Jose-WaitNRest/PCB-Madre/PCB/PCB-Madre.kicad_pcb

## KiCad design PCB/PCB-Madre.kicad_pcb (2026-04-07)

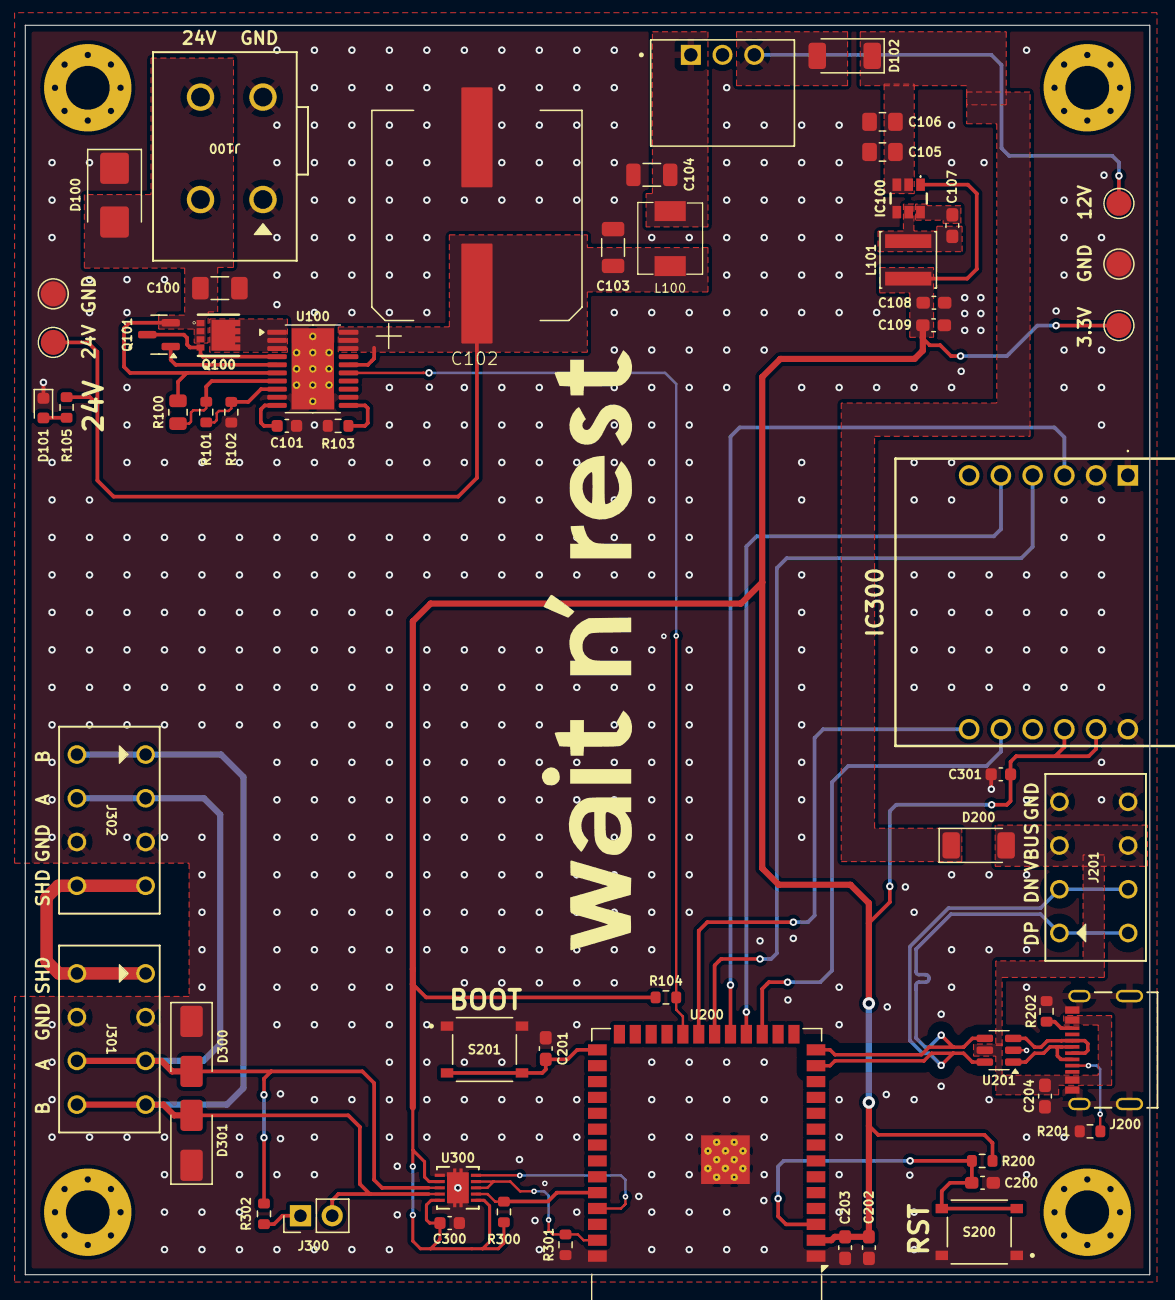
[picture p1: board PCB-Madre.kicad_pcb from above]

Board: 4 copper layers, 90.0 x 100.0 mm, 63 parts (0 on the bottom side), 39 nets.

Parts:
C100: 1uF; C_1206_3216Metric_Pad1.33x1.80mm_HandSolder
C101, C300, C301: 0.1uF; C_0603_1608Metric
C102: 1mF/50V; VKMI1701H102MV
C103, C104: 22uF; C_1206_3216Metric
C105, C106: 10uF; C_0805_2012Metric_Pad1.18x1.45mm_HandSolder
C107, C200, C201, C203, C204: 0.1uF; C_0603_1608Metric_Pad1.08x0.95mm_HandSolder
C108, C109, C202: 22uF; C_0603_1608Metric_Pad1.08x0.95mm_HandSolder
D100: SMBJ28CA-13-F; D_SMB
D101: 19-21/GHC-YR1S2/4T; LED_0603_1608Metric
D102, D200: PMEG3030EP,115; D_SOD-128
D300, D301: SMAJ30CA; D_SMA
H1, H2, H3, H4: MountingHole_Pad; MountingHole_3.5mm_Pad_Via
IC100: AP63203WU-7; AP63203WU7
IC300: WIZ850IO
J100: 2604-3102
J200: 2171790001; MOLEX_2171790001
J201, J301, J302: 2086-1104; 2086-1104-THT
J300: jumper; PinHeader_1x02_P2.54mm_Vertical
L100: 4.7uH; MDA5030-4R7M
L101: 3.9uH; L_Sunlord_SWPA4030S
PS100: R-78K12-2.0; R-78K12-2_0
Q100: CSD19537Q3
Q101: BSS138; SOT-23
R100: 825K; R_0805_2012Metric
R101: 31.6K; R_0603_1608Metric
R102: 34K; R_0603_1608Metric
R103: 9.1K; R_0603_1608Metric
R104, R200, R300, R301: 10K; R_0603_1608Metric
R105: 2.2K; R_0603_1608Metric
R201, R202: 5.1K; R_0603_1608Metric
R302: 120; R_0603_1608Metric
S200, S201: TS-1187A-B-A-B
TP100, TP101, TP102, TP103, TP104: TestPoint; TestPoint_Pad_D2.0mm
U100: TPS26631PWP; HTSSOP-20-1EP_4.4x6.5mm_P0.65mm_EP3.4x6.5mm_Mask2.96x2.96mm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
U200: ESP32-S3-WROOM-1
U201: USBLC6-2SC6; SOT-23-6
U300: THVD2450VDRCR; VSON10_DRC_TEX

Connections:
+3.3V: C108.1, C109.1, C202.1, C203.1, C300.1, C301.1, IC100.1 (FB), IC300.J22 (3.3V_1), IC300.J23 (3.3V_2), L101.2, R104.1, R200.1, R300.1, TP103.1, U200.2 (3V3), U300.1 (VIO), U300.7 (SLR), U300.10 (VCC)
+12V: D102.2 (A), PS100.3 (+VOUT), TP102.1
+24V: C102.1, C103.1, L100.1, R105.1, TP100.1, U100.16 (PGTH), U100.18 (OUT), U100.19 (OUT), U100.20 (OUT)
/12V_5V: C105.1, C106.1, D102.1 (K), D200.1 (K), IC100.2 (EN), IC100.3 (VIN)
/MCU/BOOT: C201.1, S201.C, S201.D, U200.27 (IO0)
/MCU/CLK: IC300.J14 (SCLK), U200.20 (IO12)
/MCU/CS: IC300.J15 (SCNN), U200.18 (IO10)
/MCU/EN: C200.1, R200.2, S200.C, S200.D, U200.3 (EN)
/MCU/FLT: R104.2, U100.15 (~FLT), U200.22 (IO14)
/MCU/MISO: IC300.J26 (MISO), U200.21 (IO13)
/MCU/MOSI: IC300.J13 (MOSI), U200.19 (IO11)
/MCU/N: J200.A7 (DN1), J200.B7 (DN2), U201.1 (I/O1)
/MCU/P: J200.A6 (DP1), J200.B6 (DP2), U201.3 (I/O2)
/MCU/RS485_EN: R301.1, U200.39 (IO1), U300.3 (DE), U300.4 (*RE)
/MCU/RST: IC300.J25 (RSTN), U200.17 (IO9)
/MCU/RX: R300.2, U200.36 (RXD0), U300.2 (R)
/MCU/TX: U200.37 (TXD0), U300.5 (D)
/MCU/USB_N: J201.P2_1, J201.P2_2, U200.13 (IO19), U201.6 (I/O1)
/MCU/USB_P: J201.P1_1, J201.P1_2, U200.14 (IO20), U201.4 (I/O2)
/PERIPHERALS/A: D300.2 (A2), J301.P3_1, J301.P3_2, J302.P2_1, J302.P2_2, R302.2, U300.8 (A)
/PERIPHERALS/B: D301.2 (A2), J300.2, J301.P4_1, J301.P4_2, J302.P1_1, J302.P1_2, U300.9 (B)
/PERIPHERALS/SHIELD: J301.P1_1, J301.P1_2, J302.P4_1, J302.P4_2
/POWER/INPUT: C100.1, D100.2 (A2), J100.3 (2_1), J100.4 (2_2), Q100.1 (S), Q101.2 (S), R100.1, U100.6 (IN_SYS)
GND: C100.2, C101.1, C102.2, C103.2, C104.2, C105.2, C106.2, C108.2, C109.2, C200.2, C201.2, C202.2, C203.2, C204.2, C300.2, C301.2, D100.1 (A1), D101.1 (K), D300.1 (A1), D301.1 (A1), IC100.4 (GND), IC300.J11 (GND_1), IC300.J12 (GND_2), IC300.J21 (GND_3), J100.1 (1_1), J100.2 (1_2), J200.A1B12 (GND1), J200.B1A12 (GND2), J200.SH1 (SHIELD1), J200.SH2 (SHIELD2), J200.SH3 (SHIELD3), J200.SH4 (SHIELD4), J201.P4_1, J201.P4_2, J301.P2_1, J301.P2_2, J302.P3_1, J302.P3_2, PS100.2 (GND), R102.2, R103.2, R201.2, R202.2, R301.2, S200.A, S200.B, S201.A, S201.B, TP101.1, TP104.1, U100.9 (GND), U100.12 (MODE), U100.21 (GND), U200.1 (GND), U200.40 (GND), U200.41 (GND), U201.2 (GND), U300.6 (GND), U300.11 (GND)
unnamed: D101.2 (A), R105.2
unnamed: C107.2, IC100.6 (BST)
unnamed: C107.1, IC100.5 (SW), L101.1
unnamed: J200.A5 (CC1), R201.1
unnamed: J200.B5 (CC2), R202.1
unnamed: J300.1, R302.1
unnamed: C104.1, L100.2, PS100.1 (+VIN)
unnamed: Q100.3 (D), U100.1 (IN), U100.2 (IN), U100.3 (IN)
unnamed: Q100.2 (G), Q101.3 (D), U100.4 (B_GATE)
unnamed: Q101.1 (G), U100.5 (DRV)
unnamed: R103.1, U100.11 (ILIM)
unnamed: R101.2, R102.1, U100.8 (OVP)
unnamed: R100.2, R101.1, U100.7 (UVLO)
unnamed: C101.2, U100.10 (dVdT)
VBUS: C204.1, D200.2 (A), J200.A4B9 (VBUS1), J200.B4A9 (VBUS2), J201.P3_1, J201.P3_2, U201.5 (VBUS)
