Jose-WaitNRest/PCB-Madre/(commit log)

2026-03-17 Creacion de la estructura
    Se creo:
    - Estructura de los folders
    - Creación del archivo KICAD
    - 80% del esquematico
    [MCU.kicad_sch, PCB-Madre.kicad_pcb, PCB-Madre.kicad_sch, PERIPHERALS.kicad_sch, POWER.kicad_sch]
2026-03-18 pcb board terminada
    Se termino:
    - PCB board
    - Labels de conectores y logo de la empresa
    - Conexion WIZ850IO
    - Conexion de MCU y WIZ850IO
    [MCU.kicad_sch, PCB-Madre.kicad_pcb, PCB-Madre.kicad_sch]
2026-04-05 Mejora de ruteo
    - Se ha mejorado el ruteo del sector de potencia
    [PCB-Madre.kicad_pcb]
2026-04-06 Cambio del footprint Efuse
    - Se ha cambiado el footorint de chip Efuse debido a que el utilizado no habia stock en JLCPCB
    - Se ha creado los archivos de configuracion para JLCPCB
    [PCB-Madre.kicad_pcb, POWER.kicad_sch, bom.csv, designators.csv, positions - Copy.csv, positions.csv]
2026-04-07 Fix Stitching vias y USB trace clearance
    * Se eliminaron las vías que se encontraban demasiado cercanas a componentes o a ciertas zonas, lo cual representaba un problema común generado por el uso de *stitching vias*.
    * Se definió un *clearance* de 0.8 mm para las pistas USB, con el fin de respetar el cálculo de impedancia bajo una configuración *no coplanar*. Esto se debe a que, al estar la PCB completamente rodeada por GND, el par diferencial USB pasaba a comportarse como coplanar. Solo se considera no coplanar cuando existe una separación mínima de tres veces el ancho de la pista (0.286 mm), es decir, aproximadamente 0.8 mm. Esta condición se implementó mediante el uso de *Custom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
    [PCB-Madre.kicad_pcb]
